kecajtop/ESPhome_greenhouse_controller/pic/pic2.png

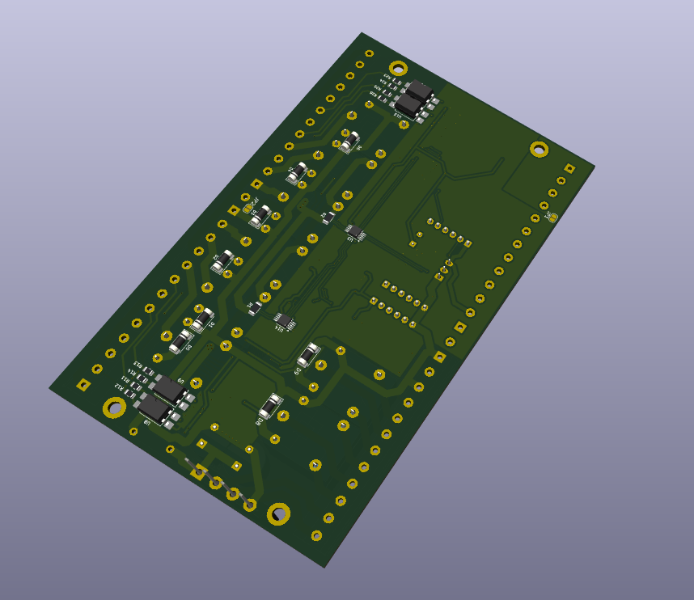
pic/pic2.png
