kecajtop/ESPhome_greenhouse_controller/pic/pic1.png

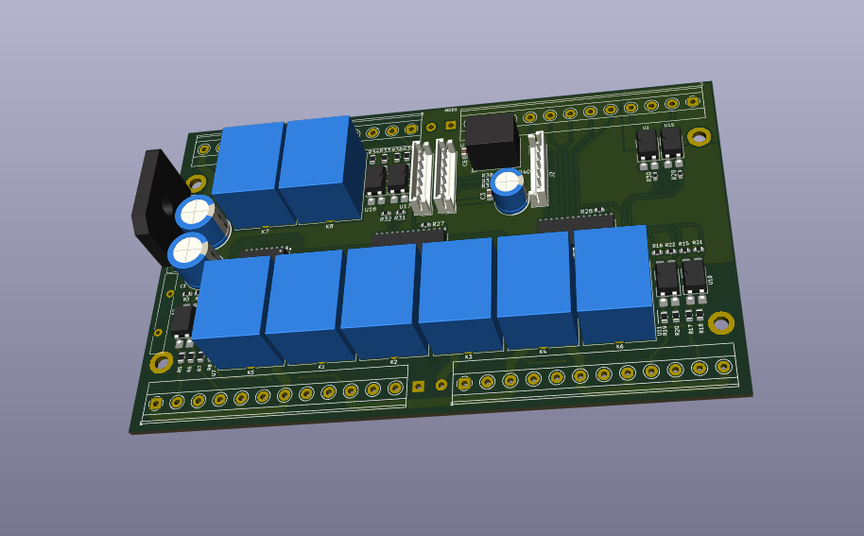
pic/pic1.png
