kecajtop/ESPhome_greenhouse_controller/pcb/sch/ESPhome_greenhouse_controller.pdf

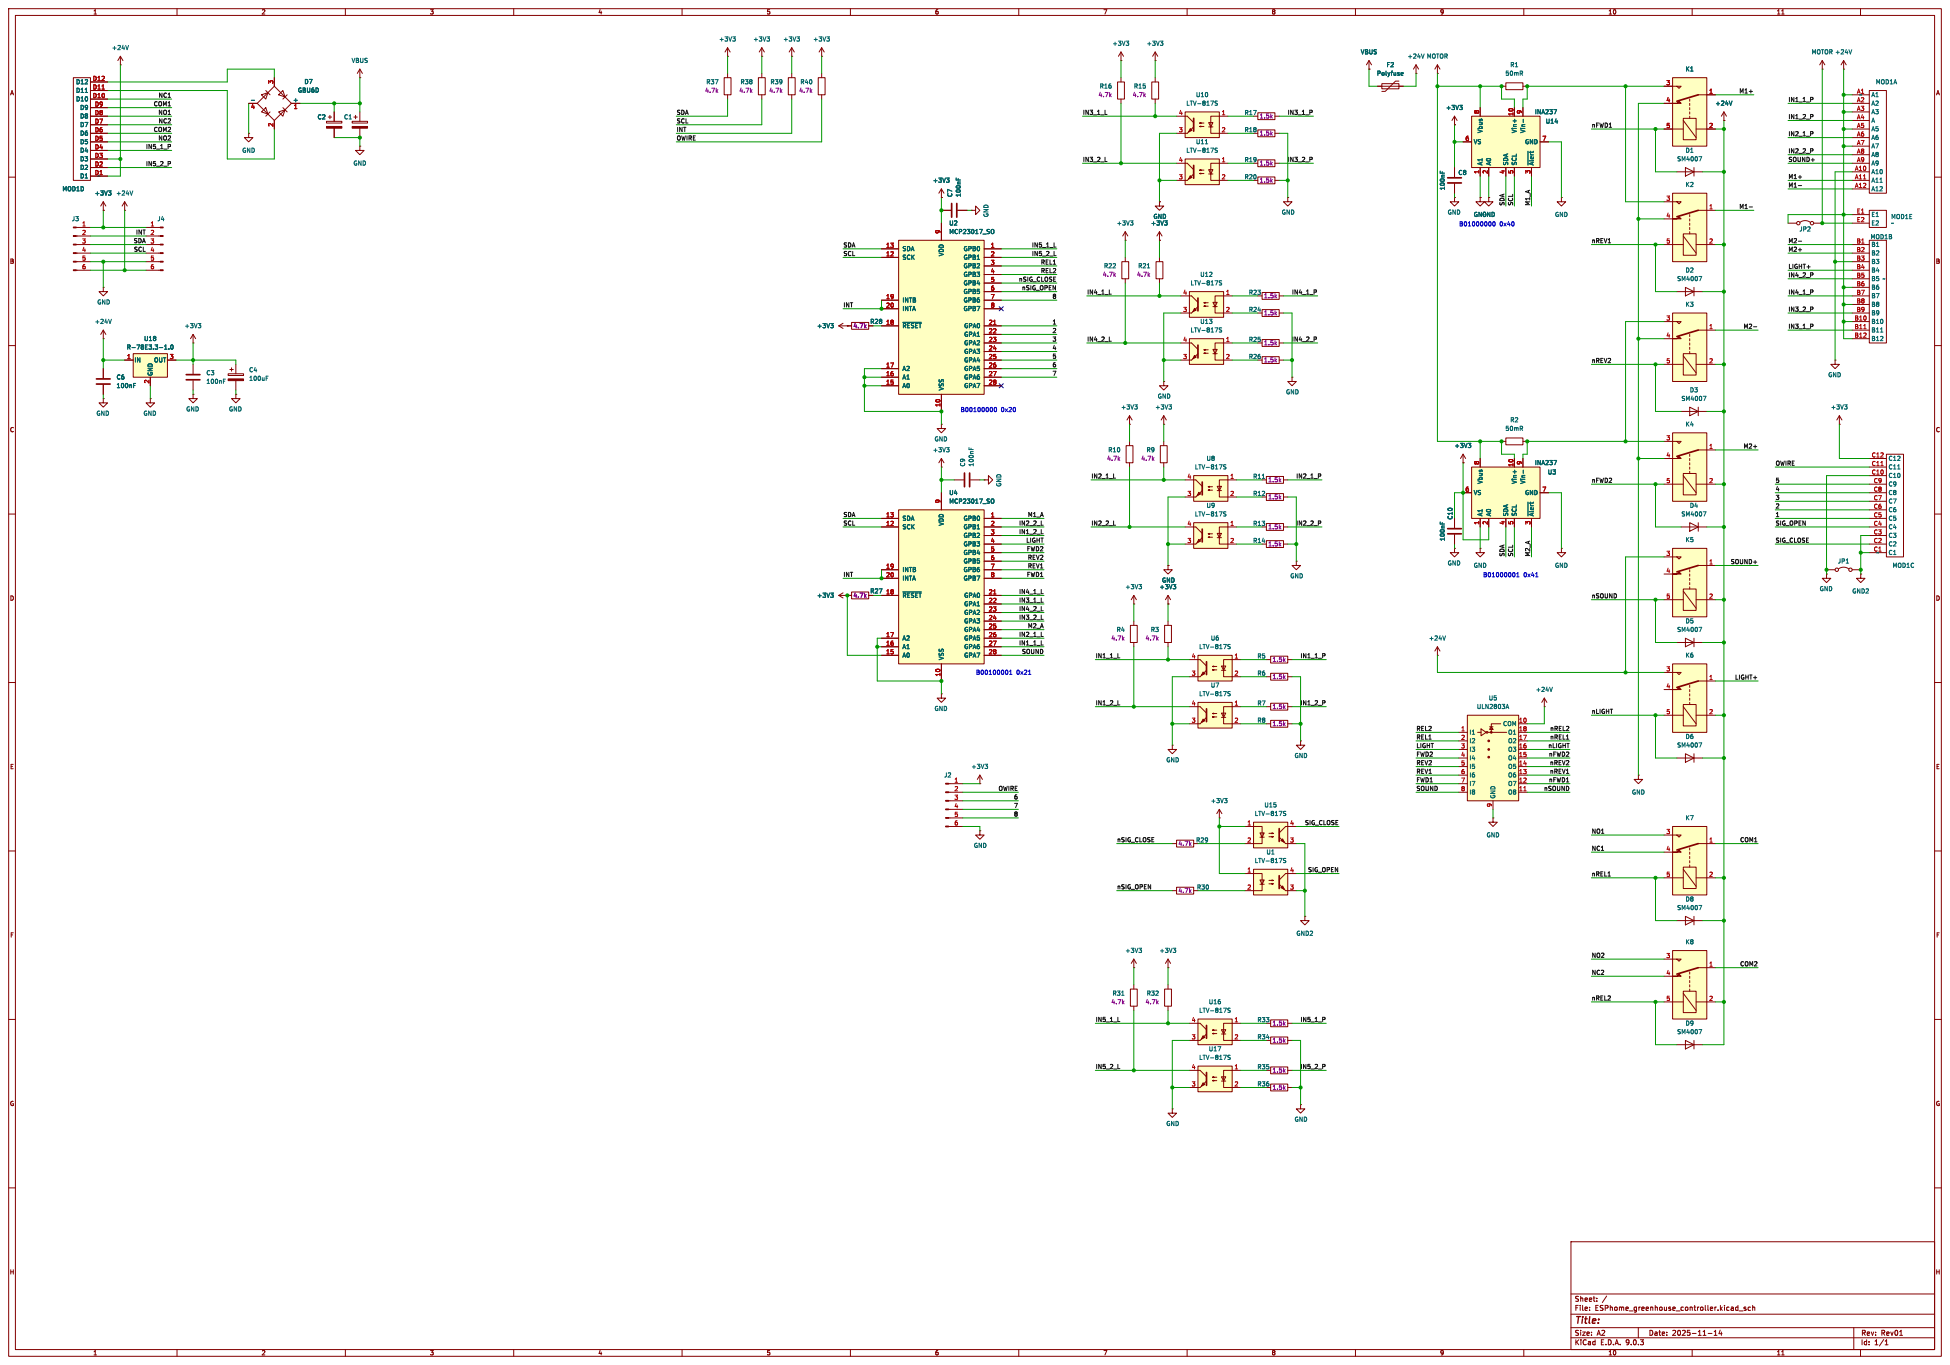
[picture p6: page 1]
