kecajtop/ESPhome_greenhouse_controller/pcb/ESPhome_greenhouse_controller.kicad_pcb

## KiCad design pcb/ESPhome_greenhouse_controller.kicad_pcb (2026-03-30)

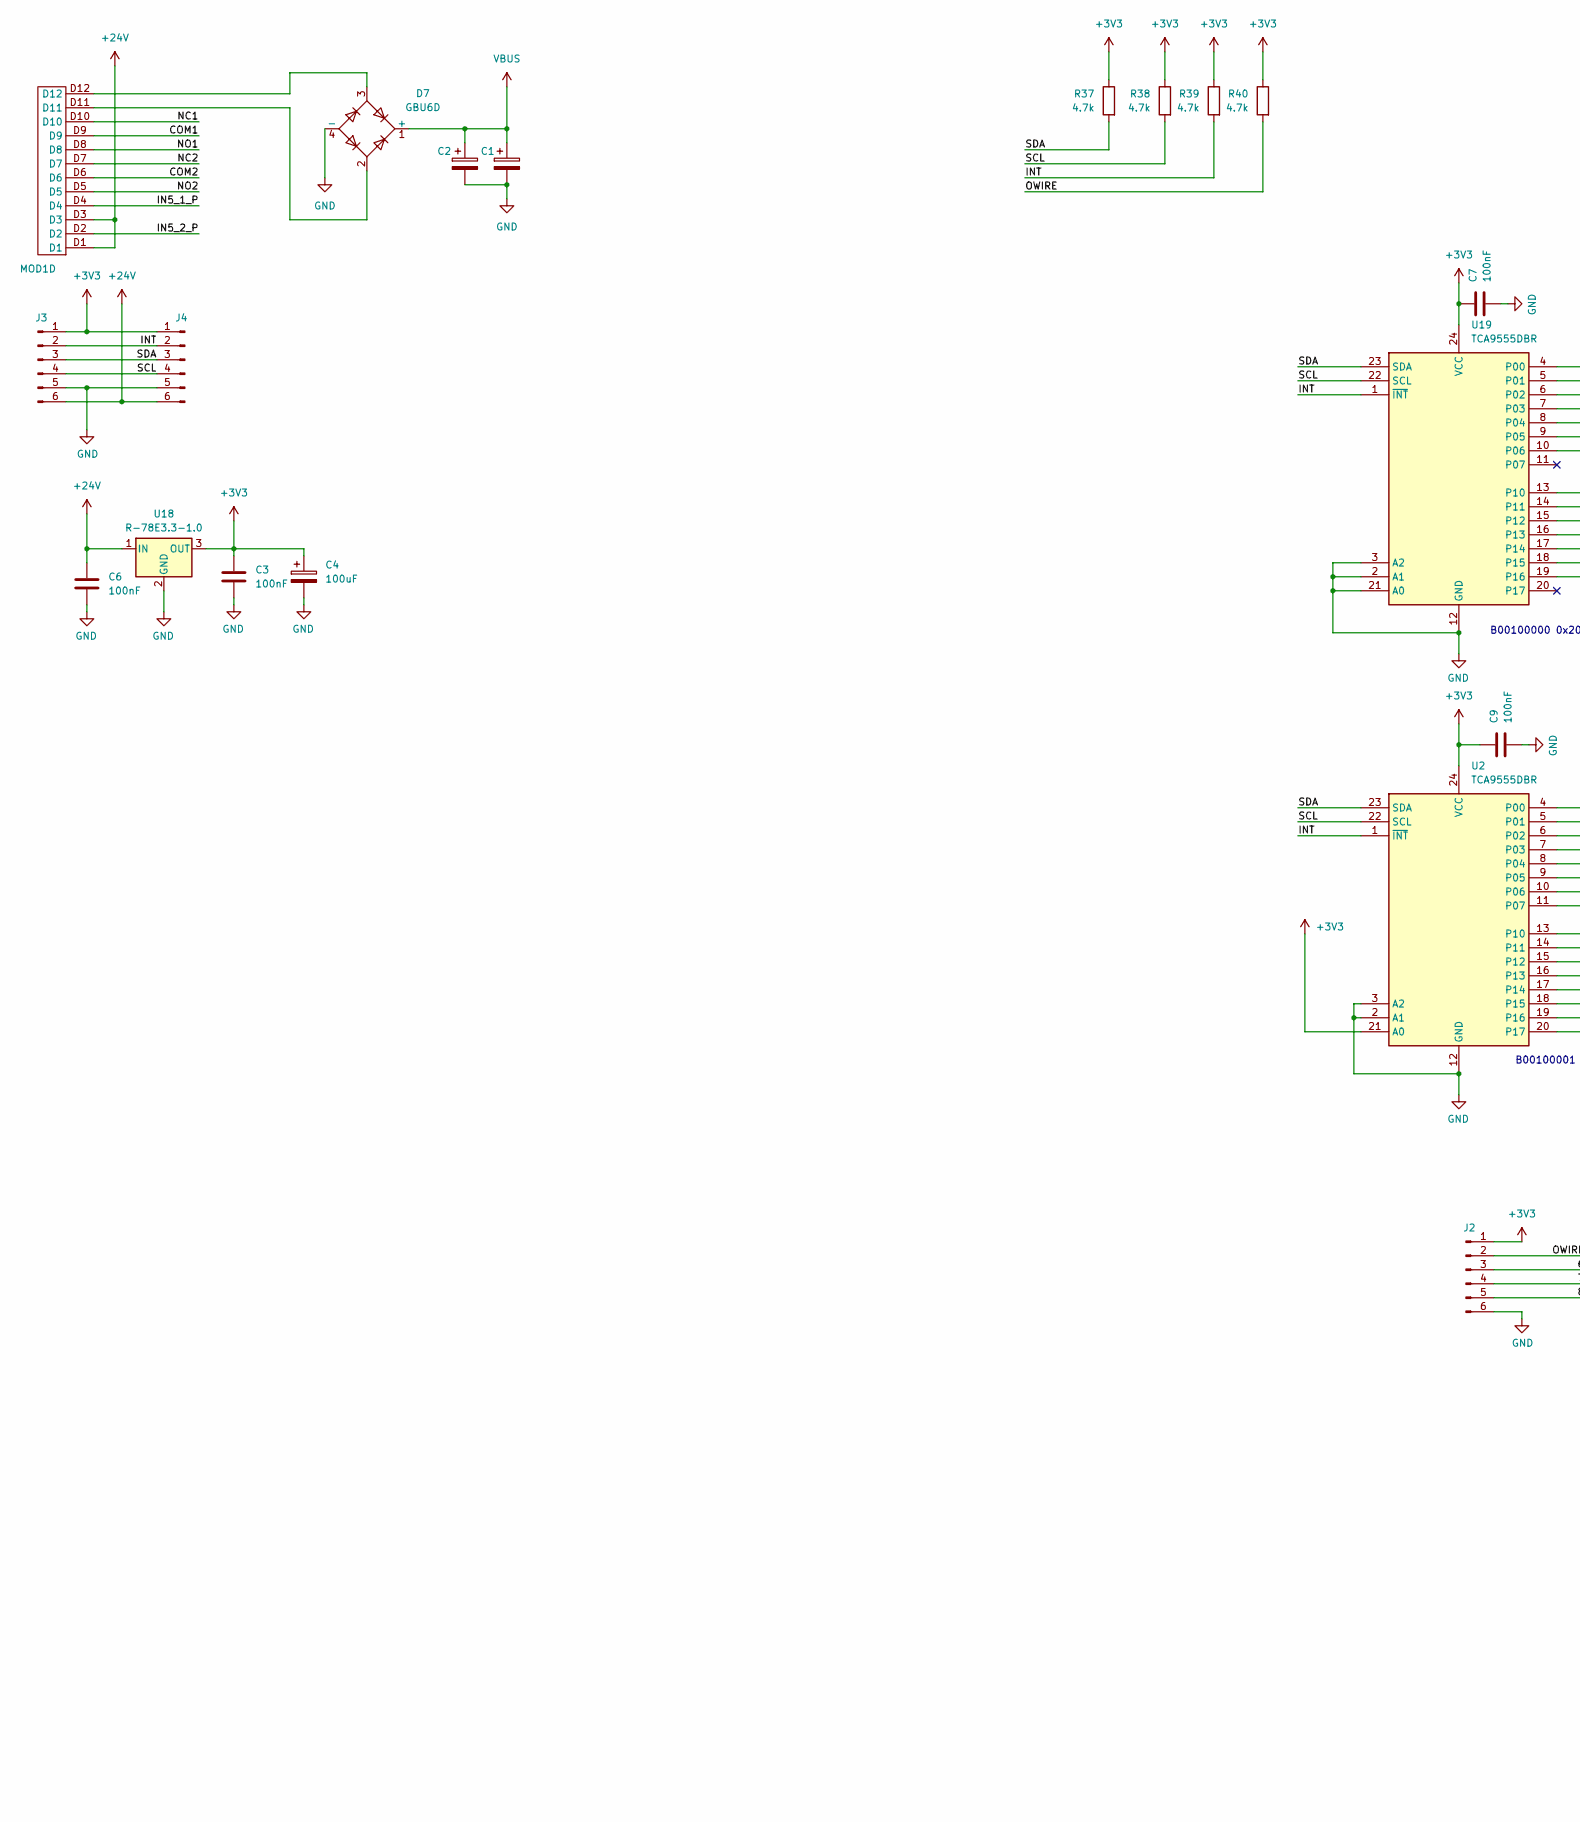
[picture p7: schematic ESPhome_greenhouse_controller.kicad_sch, part in row 1, column 1]

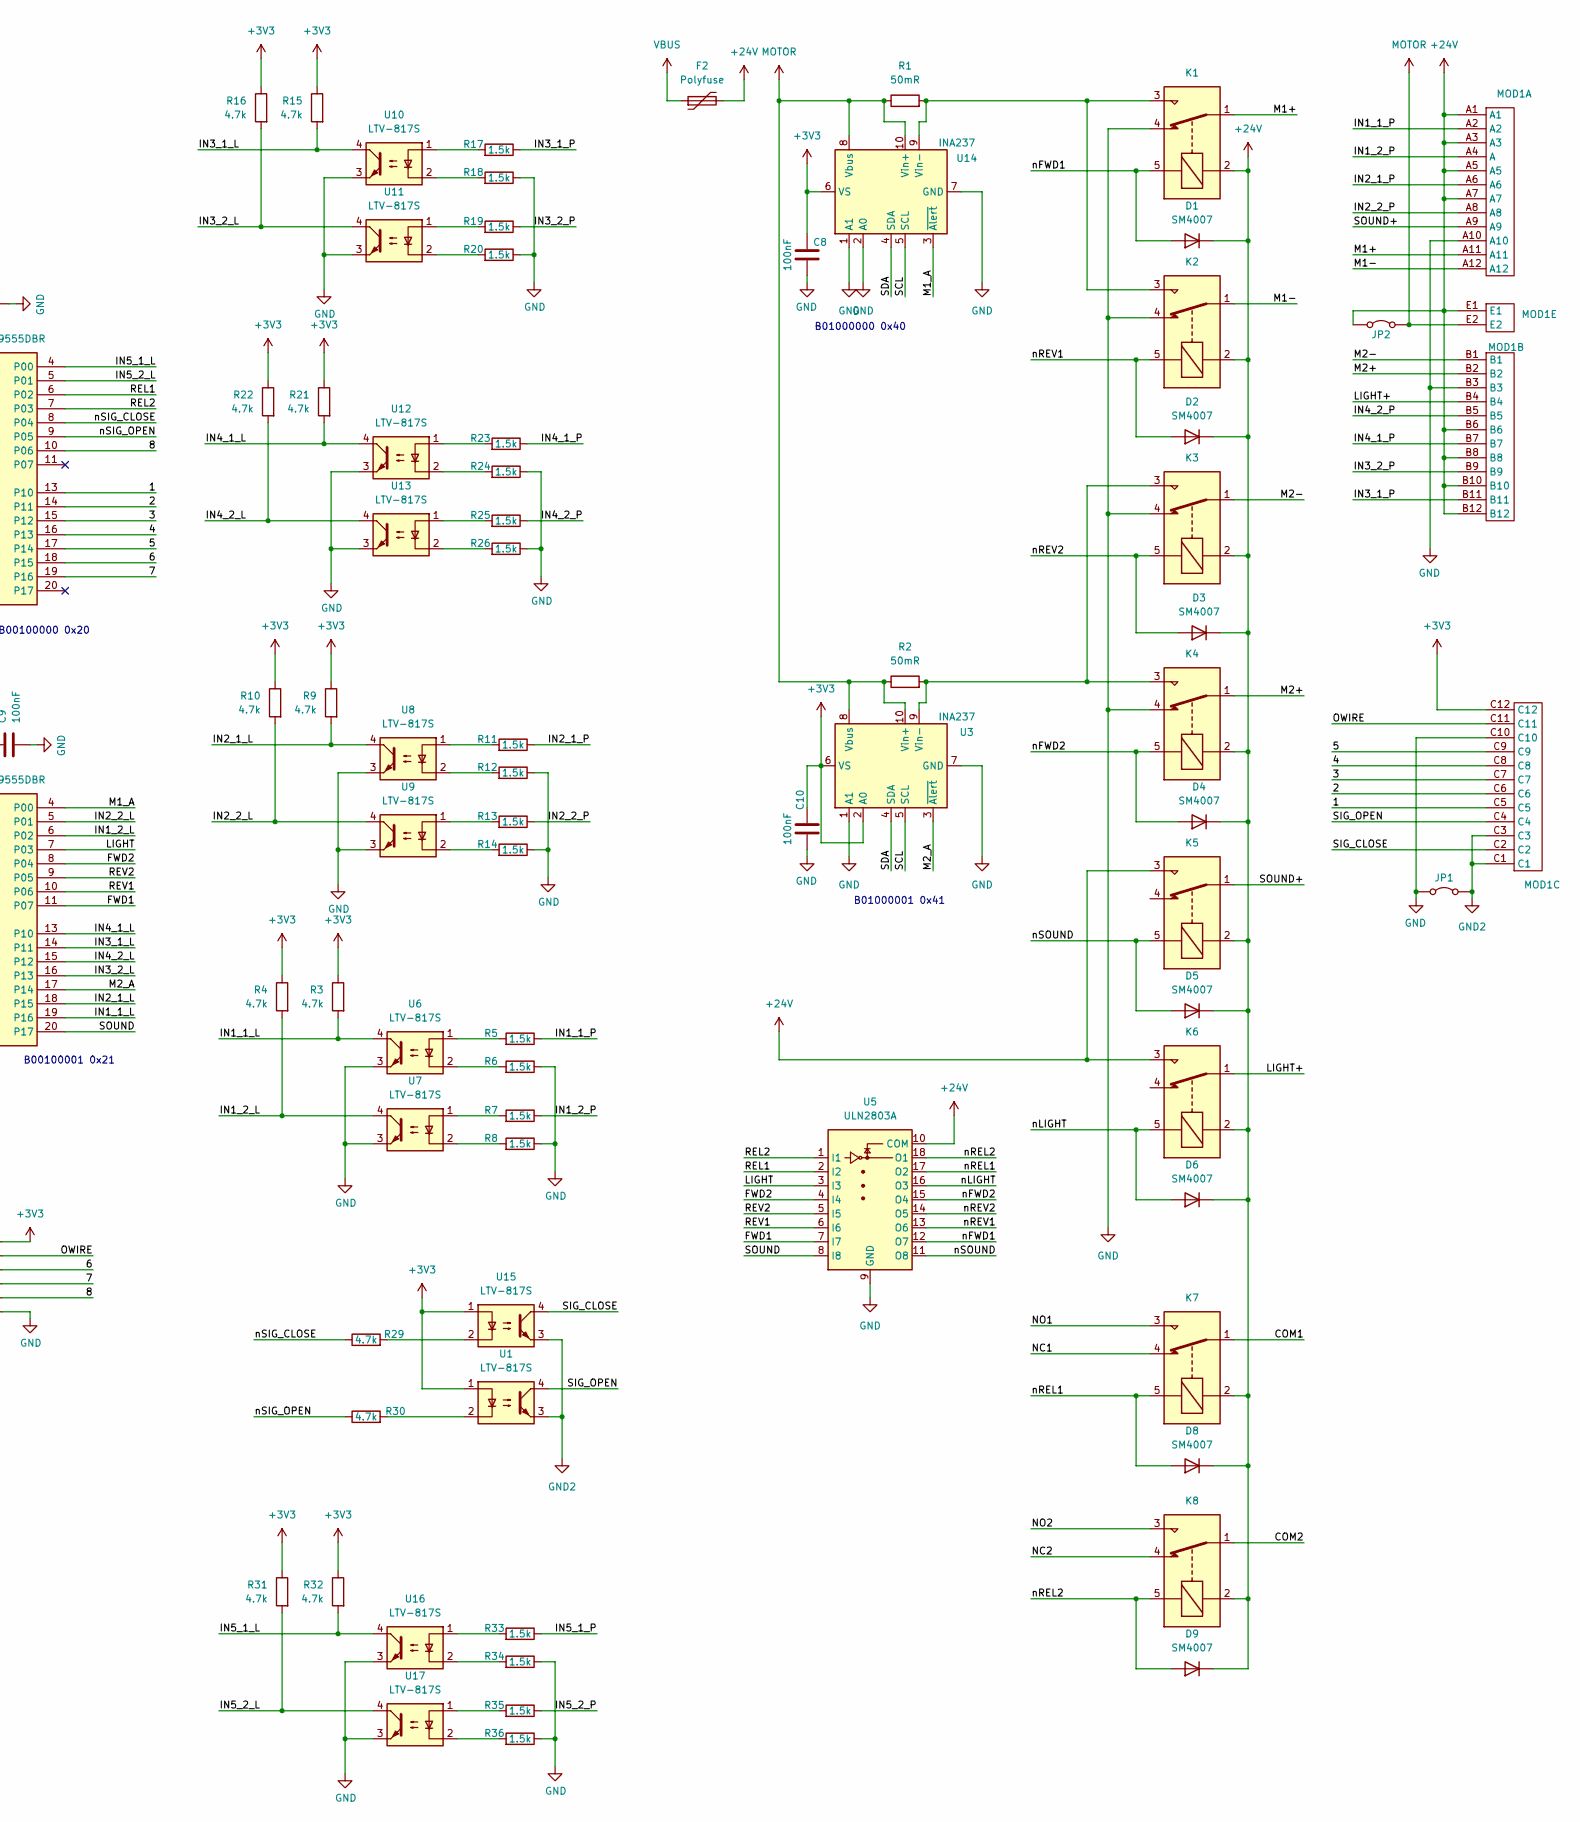
[picture p8: schematic ESPhome_greenhouse_controller.kicad_sch, part in row 1, column 2]

Parts:
C1, C2: EKM227M1HG1BRRSHP; CP_Radial_D10.0mm_P5.00mm
C3, C6: 100nF; C_0805_2012Metric
C4: 100uF; CP_Radial_D8.0mm_P3.50mm
C7, C8, C9, C10: 100nF; C_0603_1608Metric
D1, D2, D3, D4, D5, D6, D8, D9: SM4007; D_MELF
D7: GBU6D; Diode_Bridge_Vishay_GBU
F2: Polyfuse; Fuse_Bourns_MF-RHT1100
J2, J3, J4: Conn_01x05_Pin; JST_EH_B6B-EH-A_1x06_P2.50mm_Vertical
JP1, JP2: Jumper_2_Bridged; SolderJumper-2_P1.3mm_Open_RoundedPad1.0x1.5mm
K1, K2, K3, K4, K5, K6, K7, K8: SANYOU_SRD_Form_C; Relay_SPDT_SANYOU_SRD_Series_Form_C
MOD1: ZD1008
R1, R2: 50mR; R_1206_3216Metric
R3, R4, R9, R10, R15, R16, R21, R22, R29, R30, R31, R32, R37, R38, R39, R40: R0603_4.7k_1%_100mW_100PPM_AC; R_0603_1608Metric; Manufacturer Part Number AC0603FR-074K7L; LCSC C23162
R5, R6, R7, R8, R11, R12, R13, R14, R17, R18, R19, R20, R23, R24, R25, R26, R33, R34, R35, R36: R0805_1.5k_1%_125mW_100PPM_AC; R_0805_2012Metric; Manufacturer Part Number AC0805FR-071K5L; LCSC C22843
U1, U6, U7, U8, U9, U10, U11, U12, U13, U15, U16, U17: LTV-817S; SMDIP-4_W9.53mm; LCSC C109225
U2, U19: TCA9555DBR; SSOP-24_5.3x8.2mm_P0.65mm
U3, U14: INA237; VSSOP-10_3x3mm_P0.5mm; LCSC C2864837
U5: ULN2803A; SOIC-18W_7.5x11.6mm_P1.27mm; LCSC C9683
U18: R-78E3.3-1.0; Converter_DCDC_RECOM_R-78E-0.5_THT

Connections:
+3V3: C3.1, C4.1, C7.1, C8.1, C9.1, C10.1, J2.1, J3.1, J4.1, MOD1.C12, R3.1, R4.1, R9.1, R10.1, R15.1, R16.1, R21.1, R22.1, R31.1, R32.1, R37.1, R38.1, R39.1, R40.1, U1.1, U2.21 (A0), U2.24 (VCC), U3.2 (A0), U3.6 (VS), U14.6 (VS), U15.1, U18.3 (OUT), U19.24 (VCC)
+24V: C6.1, D1.1 (K), D2.1 (K), D3.1 (K), D4.1 (K), D5.1 (K), D6.1 (K), D8.1 (K), D9.1 (K), F2.2, J3.6, J4.6, JP2.1 (A), K1.2, K2.2, K3.2, K4.2, K5.2, K5.3, K6.2, K6.3, K7.2, K8.2, MOD1.A1, MOD1.A3, MOD1.A5, MOD1.A7, MOD1.B6, MOD1.B8, MOD1.B10, MOD1.B12, MOD1.D1, MOD1.D3, MOD1.E1, U5.10 (COM), U18.1 (IN)
/1: MOD1.C5, U19.13 (P10)
/2: MOD1.C6, U19.14 (P11)
/3: MOD1.C7, U19.15 (P12)
/4: MOD1.C8, U19.16 (P13)
/5: MOD1.C9, U19.17 (P14)
/6: J2.3, U19.18 (P15)
/7: J2.4, U19.19 (P16)
/8: J2.5, U19.10 (P06)
/COM1: K7.1, MOD1.D9
/COM2: K8.1, MOD1.D6
/FWD1: U2.11 (P07), U5.7 (I7)
/FWD2: U2.8 (P04), U5.4 (I4)
/IN1_1_L: R3.2, U2.19 (P16), U6.4
/IN1_1_P: MOD1.A2, R5.1
/IN1_2_L: R4.2, U2.6 (P02), U7.4
/IN1_2_P: MOD1.A4 (A), R7.1
/IN2_1_L: R9.2, U2.18 (P15), U8.4
/IN2_1_P: MOD1.A6, R11.1
/IN2_2_L: R10.2, U2.5 (P01), U9.4
/IN2_2_P: MOD1.A8, R13.1
/IN3_1_L: R15.2, U2.14 (P11), U10.4
/IN3_1_P: MOD1.B11, R17.1
/IN3_2_L: R16.2, U2.16 (P13), U11.4
/IN3_2_P: MOD1.B9, R19.1
/IN4_1_L: R21.2, U2.13 (P10), U12.4
/IN4_1_P: MOD1.B7, R23.1
/IN4_2_L: R22.2, U2.15 (P12), U13.4
/IN4_2_P: MOD1.B5, R25.1
/IN5_1_L: R32.2, U16.4, U19.4 (P00)
/IN5_1_P: MOD1.D4, R33.1
/IN5_2_L: R31.2, U17.4, U19.5 (P01)
/IN5_2_P: MOD1.D2, R35.1
/INT: J3.2, J4.2, R39.2, U2.1 (~INT), U19.1 (~INT)
/LIGHT: U2.7 (P03), U5.3 (I3)
/LIGHT+: K6.1, MOD1.B4
/M1+: K1.1, MOD1.A11
/M1-: K2.1, MOD1.A12
/M1_A: U2.4 (P00), U14.3 (~Alert)
/M2+: K4.1, MOD1.B2
/M2-: K3.1, MOD1.B1
/M2_A: U2.17 (P14), U3.3 (~Alert)
/NC1: K7.4, MOD1.D10
/NC2: K8.4, MOD1.D7
/NO1: K7.3, MOD1.D8
/NO2: K8.3, MOD1.D5
/OWIRE: J2.2, MOD1.C11, R40.2
/REL1: U5.2 (I2), U19.6 (P02)
/REL2: U5.1 (I1), U19.7 (P03)
/REV1: U2.10 (P06), U5.6 (I6)
/REV2: U2.9 (P05), U5.5 (I5)
/SCL: J3.4, J4.4, R38.2, U2.22 (SCL), U3.5 (SCL), U14.5 (SCL), U19.22 (SCL)
/SDA: J3.3, J4.3, R37.2, U2.23 (SDA), U3.4 (SDA), U14.4 (SDA), U19.23 (SDA)
/SIG_CLOSE: MOD1.C2, U15.4
/SIG_OPEN: MOD1.C4, U1.4
/SOUND: U2.20 (P17), U5.8 (I8)
/SOUND+: K5.1, MOD1.A9
/nFWD1: D1.2 (A), K1.5, U5.12 (O7)
/nFWD2: D4.2 (A), K4.5, U5.15 (O4)
/nLIGHT: D6.2 (A), K6.5, U5.16 (O3)
/nREL1: D8.2 (A), K7.5, U5.17 (O2)
/nREL2: D9.2 (A), K8.5, U5.18 (O1)
/nREV1: D2.2 (A), K2.5, U5.13 (O6)
/nREV2: D3.2 (A), K3.5, U5.14 (O5)
/nSIG_CLOSE: R29.1, U19.8 (P04)
/nSIG_OPEN: R30.1, U19.9 (P05)
/nSOUND: D5.2 (A), K5.5, U5.11 (O8)
GND: C1.2, C2.2, C3.2, C4.2, C6.2, C7.2, C8.2, C9.2, C10.2, D7.4 (-), J2.6, J3.5, J4.5, JP1.1 (A), K1.4, K2.4, K3.4, K4.4, MOD1.A10, MOD1.B3, MOD1.C10, R6.1, R8.1, R12.1, R14.1, R18.1, R20.1, R24.1, R26.1, R34.1, R36.1, U2.2 (A1), U2.3 (A2), U2.12 (GND), U3.1 (A1), U3.7 (GND), U5.9 (GND), U6.3, U7.3, U8.3, U9.3, U10.3, U11.3, U12.3, U13.3, U14.1 (A1), U14.2 (A0), U14.7 (GND), U16.3, U17.3, U18.2 (GND), U19.2 (A1), U19.3 (A2), U19.12 (GND), U19.21 (A0)
GND2: JP1.2 (B), MOD1.C1, MOD1.C3, U1.3, U15.3
MOTOR: JP2.2 (B), MOD1.E2, R1.1, R2.1, U3.8 (Vbus), U3.10 (Vin+), U14.8 (Vbus), U14.10 (Vin+)
unnamed: D7.2, MOD1.D11
unnamed: D7.3, MOD1.D12
unnamed: R5.2, U6.1
unnamed: R6.2, U6.2
unnamed: R7.2, U7.1
unnamed: R8.2, U7.2
unnamed: R11.2, U8.1
unnamed: R12.2, U8.2
unnamed: R13.2, U9.1
unnamed: R14.2, U9.2
unnamed: R17.2, U10.1
unnamed: R18.2, U10.2
unnamed: R19.2, U11.1
unnamed: R20.2, U11.2
unnamed: R23.2, U12.1
unnamed: R24.2, U12.2
unnamed: R25.2, U13.1
unnamed: R26.2, U13.2
unnamed: R29.2, U15.2
unnamed: R30.2, U1.2
unnamed: R33.2, U16.1
unnamed: R34.2, U16.2
unnamed: R35.2, U17.1
unnamed: R36.2, U17.2
unnamed: K3.3, K4.3, R2.2, U3.9 (Vin-)
unnamed: K1.3, K2.3, R1.2, U14.9 (Vin-)
VBUS: C1.1, C2.1, D7.1 (+), F2.1

Notes on the sheet:
B01000000 0x40
B00100000 0x20
B00100001 0x21
B01000001 0x41

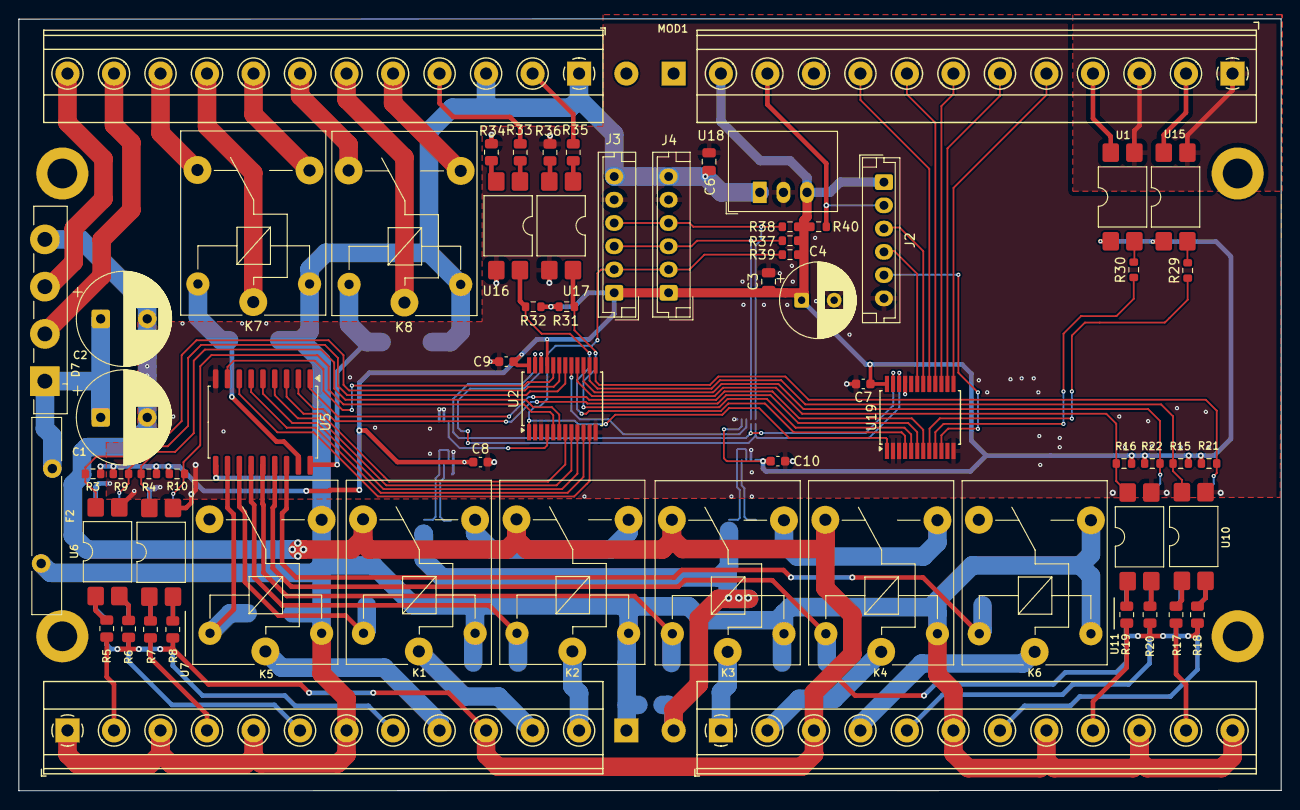
[picture p9: board pcb/ESPhome_greenhouse_controller.kicad_pcb from above]

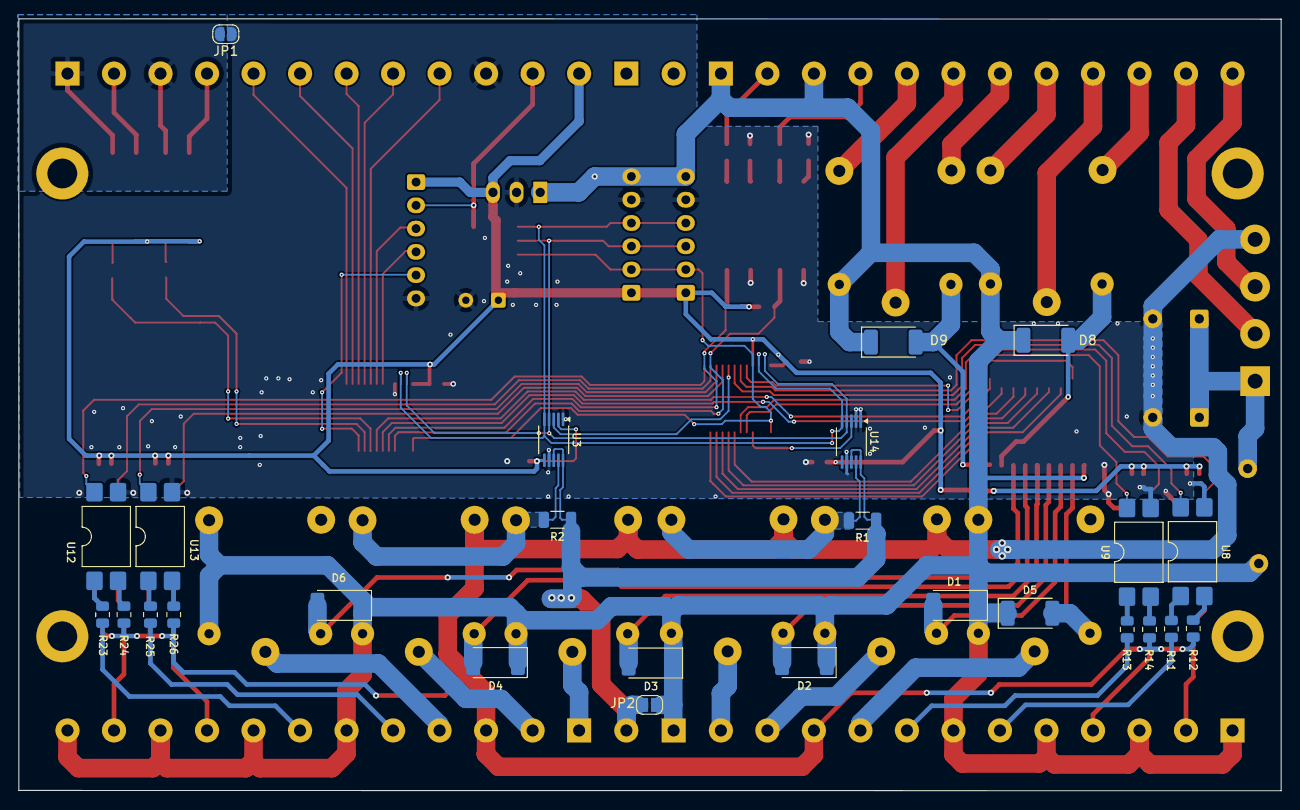
[picture p10: board pcb/ESPhome_greenhouse_controller.kicad_pcb from below]

Board: 2 copper layers, 135.7 x 83.0 mm, 89 parts (26 on the bottom side), 98 nets.
