kecajtop/ESPhome_greenhouse_controller/pcb/ESPhome_greenhouse_controller/ESPhome_greenhouse_controller.kicad_pcb

## KiCad design pcb/ESPhome_greenhouse_controller/ESPhome_greenhouse_controller.kicad_pcb (2024-08-20, an earlier design)

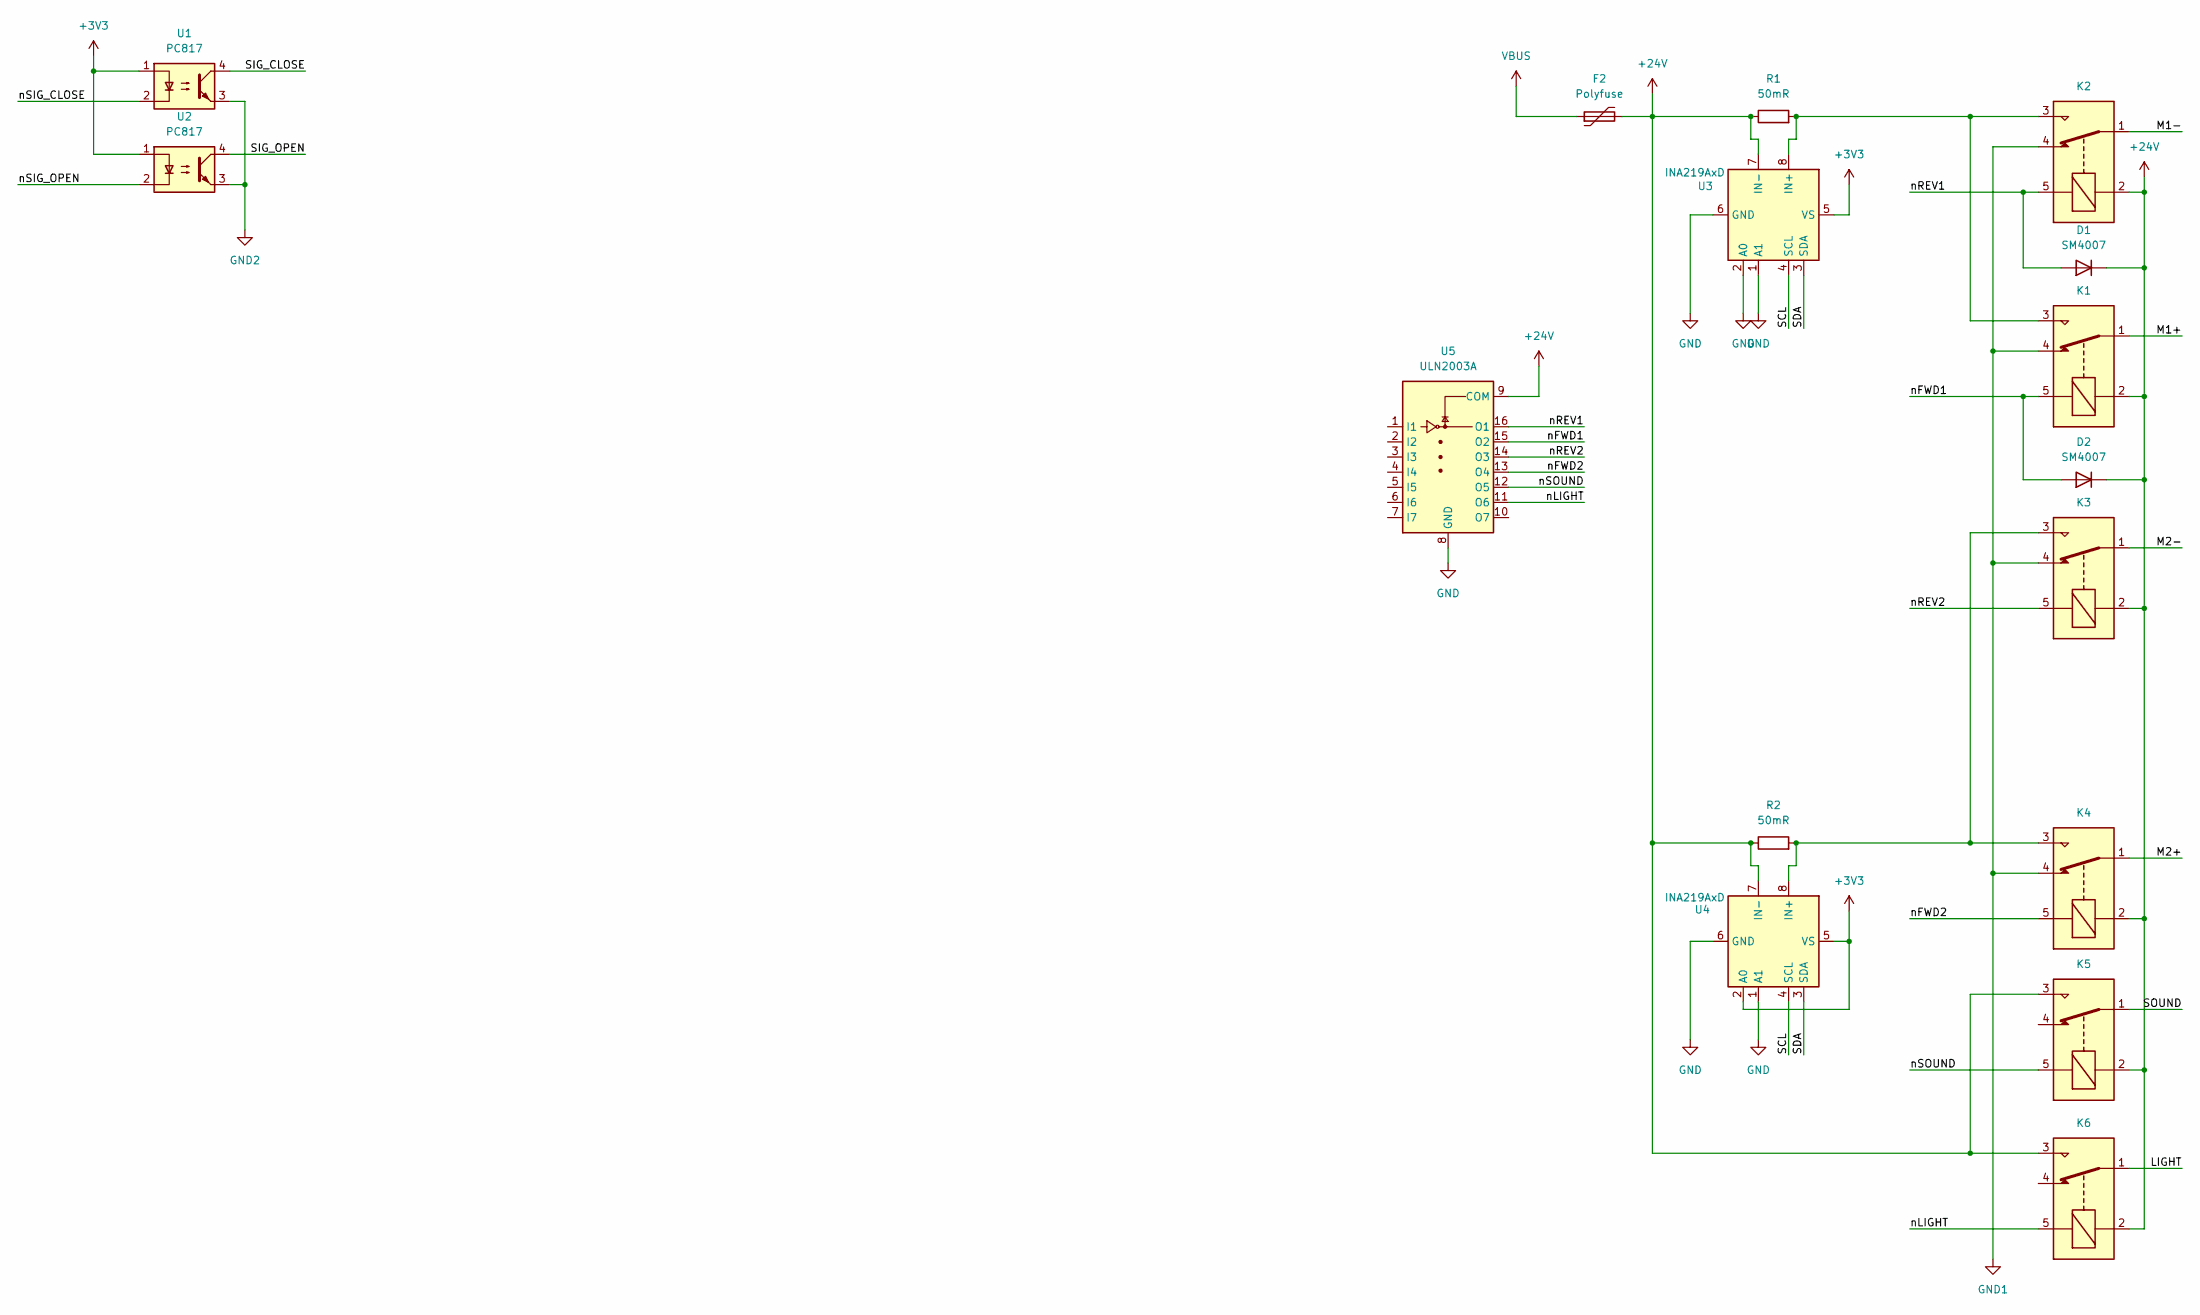
[picture p11: schematic ESPhome_greenhouse_controller.kicad_sch]

Parts:
D1, D2: SM4007; D_MELF
F2: Polyfuse; Fuse_Bourns_MF-RHT1100
K1, K2, K3, K4, K5, K6: SANYOU_SRD_Form_C; Relay_SPDT_SANYOU_SRD_Series_Form_C
R1, R2: 50mR; R_1206_3216Metric
U1, U2: PC817; DIP-4_W7.62mm
U3, U4: INA219AxD; SOIC-8_3.9x4.9mm_P1.27mm
U5: ULN2003A

Connections:
+3V3: U1.1, U2.1, U3.5 (VS), U4.2 (A0), U4.5 (VS)
+24V: D1.1 (K), D2.1 (K), F2.2, K1.2, K2.2, K3.2, K4.2, K5.2, K5.3, K6.2, K6.3, R1.1, R2.1, U3.7 (IN-), U4.7 (IN-), U5.9 (COM)
/LIGHT: K6.1
/M1+: K1.1
/M1-: K2.1
/M2+: K4.1
/M2-: K3.1
/SCL: U3.4 (SCL), U4.4 (SCL)
/SDA: U3.3 (SDA), U4.3 (SDA)
/SIG_CLOSE: U1.4
/SIG_OPEN: U2.4
/SOUND: K5.1
/nFWD1: D2.2 (A), K1.5, U5.15 (O2)
/nFWD2: K4.5, U5.13 (O4)
/nLIGHT: K6.5, U5.11 (O6)
/nREV1: D1.2 (A), K2.5, U5.16 (O1)
/nREV2: K3.5, U5.14 (O3)
/nSIG_CLOSE: U1.2
/nSIG_OPEN: U2.2
/nSOUND: K5.5, U5.12 (O5)
GND: U3.1 (A1), U3.2 (A0), U3.6 (GND), U4.1 (A1), U4.6 (GND), U5.8 (GND)
GND1: K1.4, K2.4, K3.4, K4.4
GND2: U1.3, U2.3
unnamed: K1.3, K2.3, R1.2, U3.8 (IN+)
unnamed: K3.3, K4.3, R2.2, U4.8 (IN+)
VBUS: F2.1

Board: 2 copper layers, 15 parts (0 on the bottom side), 11 nets, no tracks yet.
